mattybigback/RC2014/Boards/README.MD

# RC2014 Boards

These are the resources needed to build the boards I have designed for the RC2014.
