mattybigback/RC2014/BASIC/README.MD

# BASIC
BASIC programs that relate to my boards.
