mattybigback/RC2014/Boards/PPIDE/PPIDE_SCHEMATIC.pdf

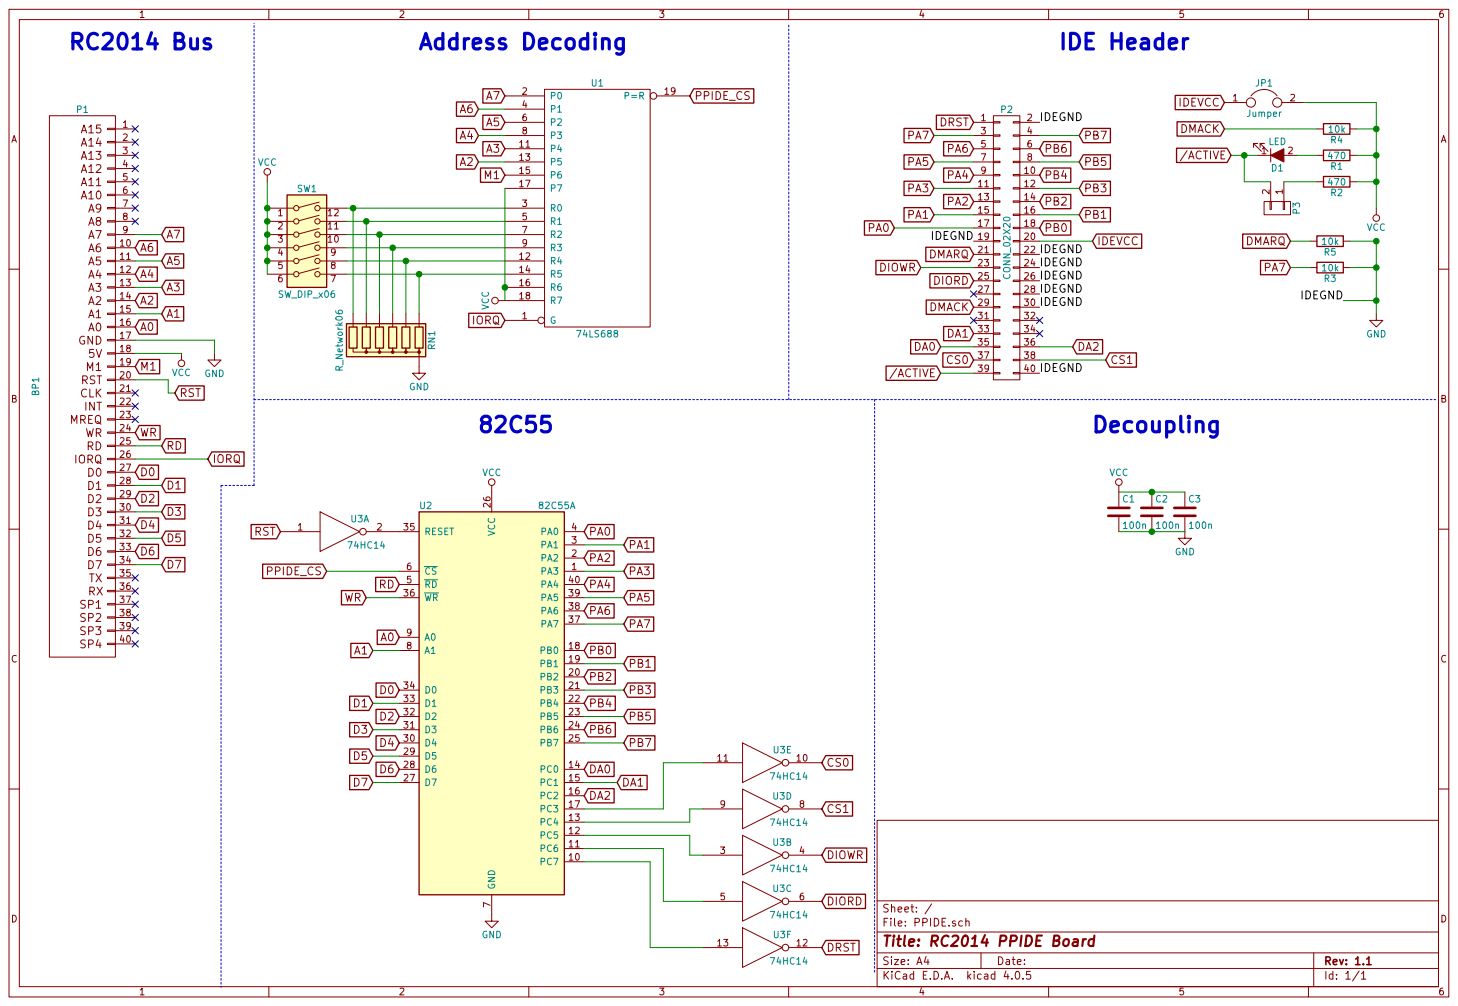
[picture p2: page 1]

File: PPIDE.sch Sheet: /
Id: 1/1 Title: RC2014 PPIDE Board
