mattybigback/RC2014/Boards/ADC Module/Schematic.pdf

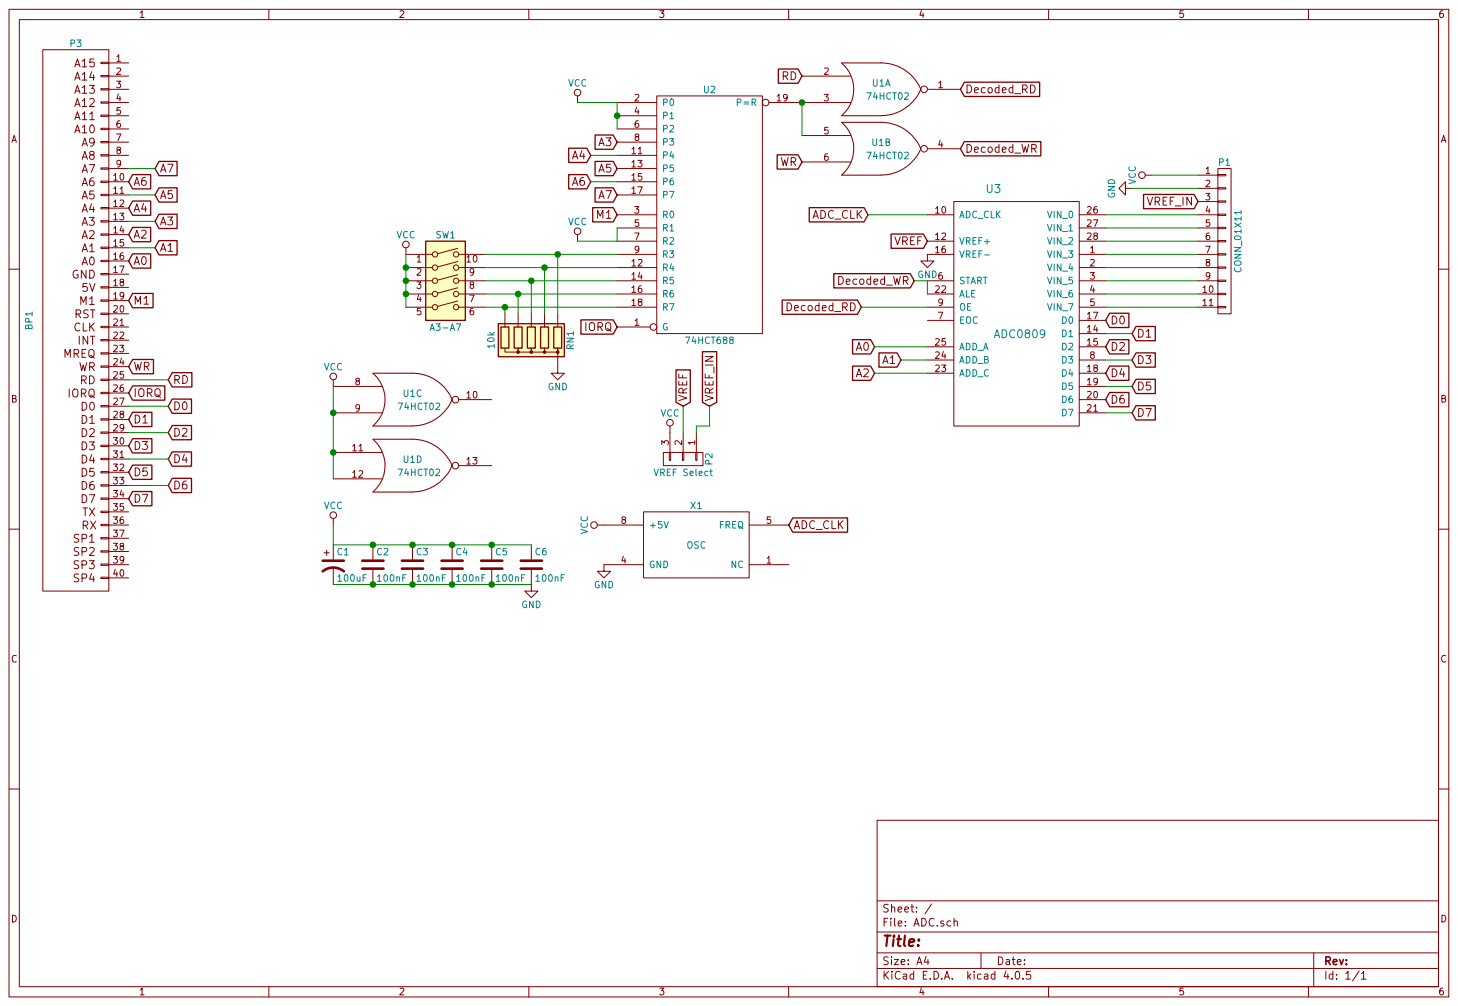
[picture p3: page 1]

Id: 1/1 Title: File: ADC.sch Sheet: /
