mattybigback/RC2014/Boards/PPIDE/KiCAD/PPIDE.kicad_pcb

## KiCad design Boards/PPIDE/KiCAD/PPIDE.kicad_pcb (2017-10-03)

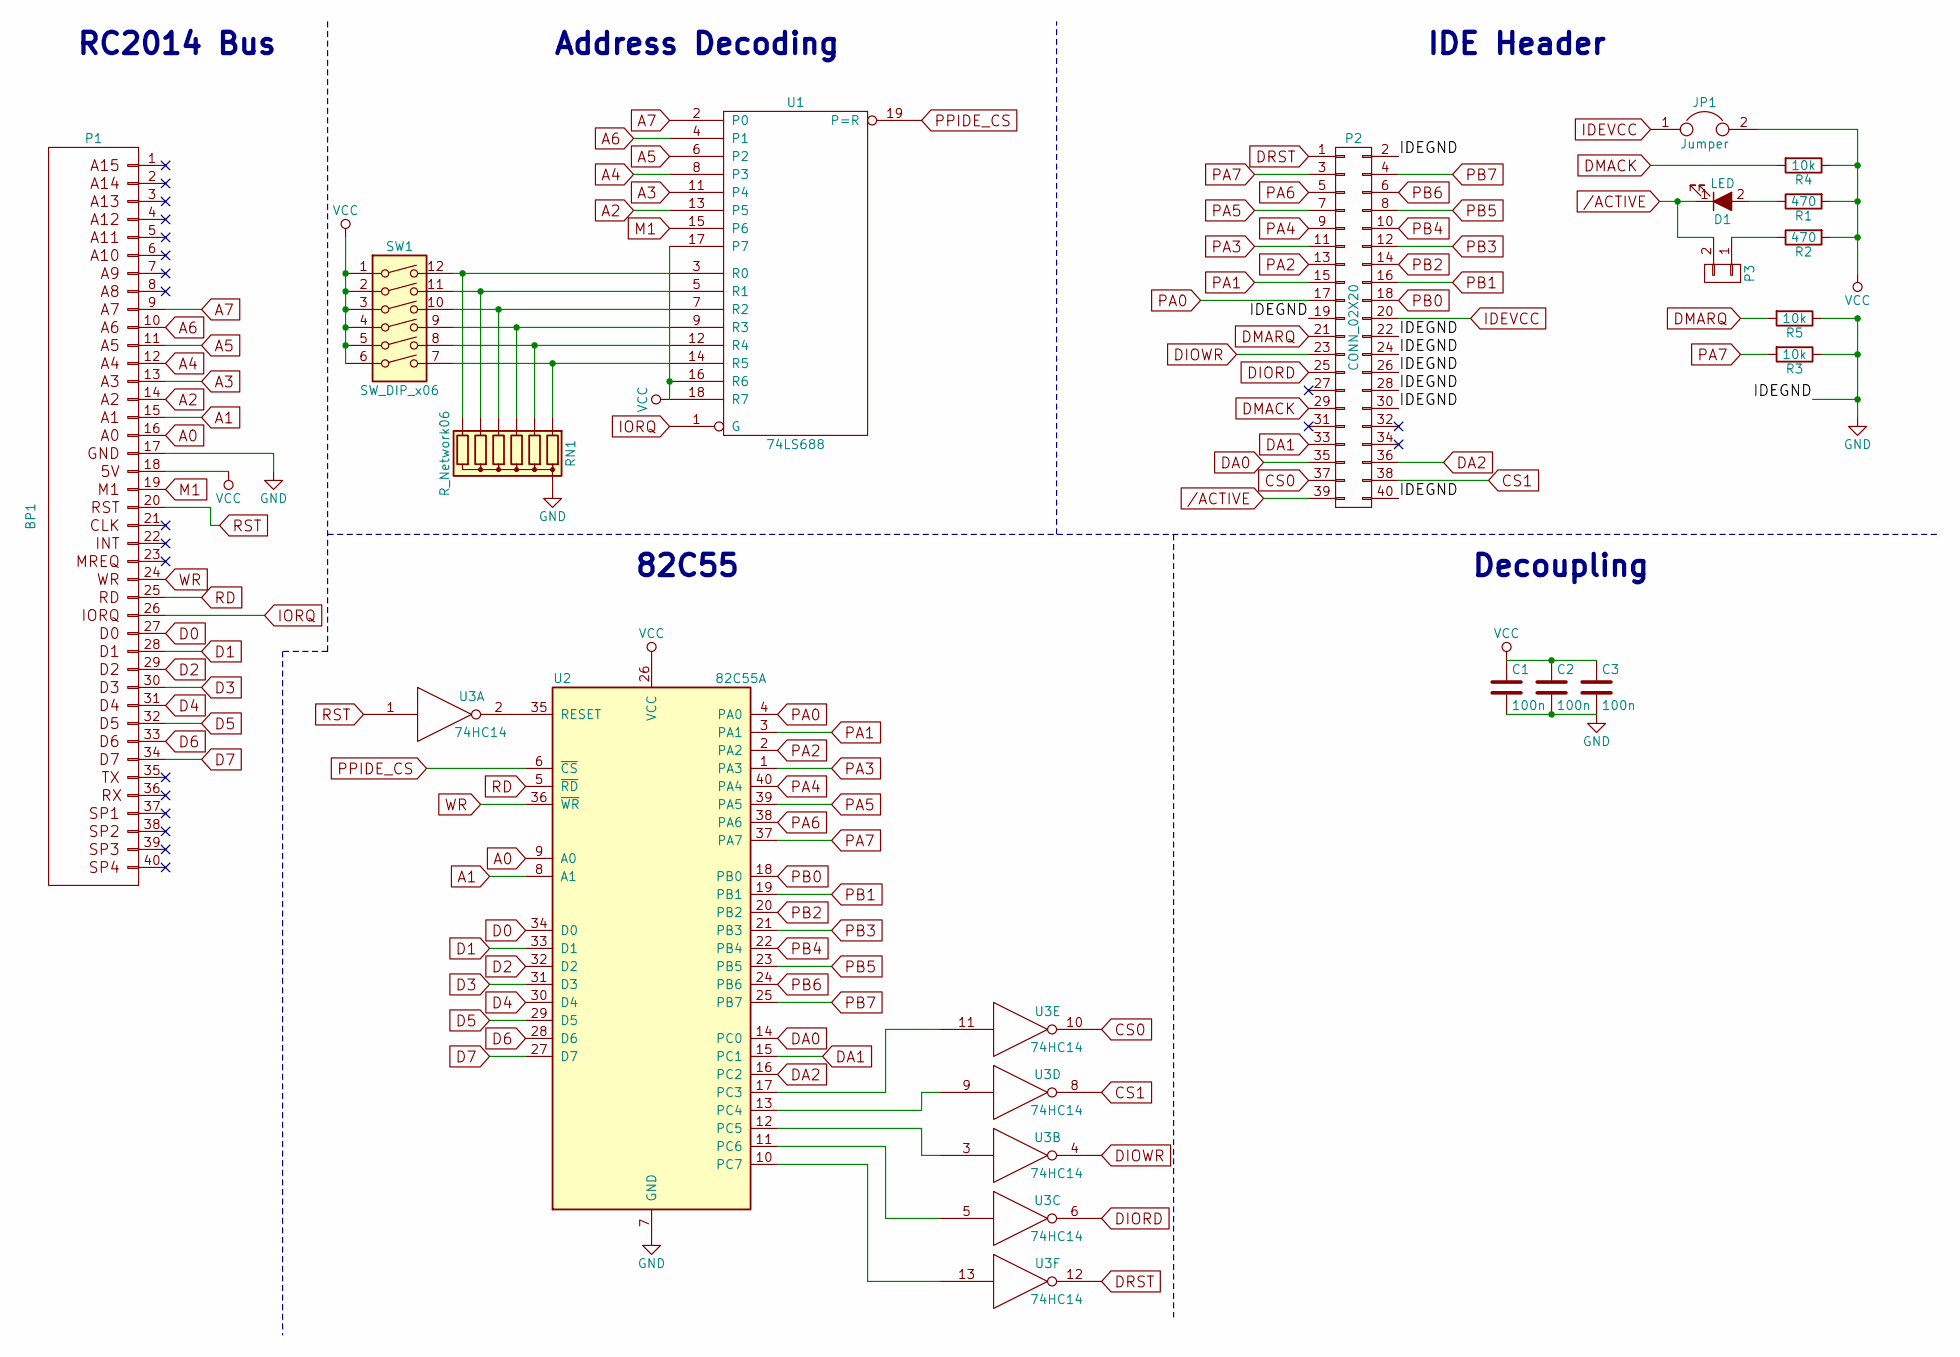
[picture p4: schematic PPIDE.sch, RC2014 PPIDE Board]

Parts:
C1, C2, C3: 100n; C_Disc_D10.0mm_W2.5mm_P5.00mm
D1: LED; LED_D5.0mm_FlatTop
JP1: Jumper; Pin_Header_Straight_1x02_Pitch2.54mm
P1: BP1; Pin_Header_Straight_1x39_Pitch2.54mm
P2: CONN_02X20; IDC_Header_Straight_40pins
P3: CONN_01X02; Pin_Header_Straight_1x02_Pitch2.54mm
R1, R2: 470; R_Axial_DIN0207_L6.3mm_D2.5mm_P10.16mm_Horizontal
R3, R4, R5: 10k; R_Axial_DIN0207_L6.3mm_D2.5mm_P10.16mm_Horizontal
RN1: R_Network06; R_Array_SIP7
SW1: SW_DIP_x06; SW_DIP_x6_W7.62mm_Slide
U1: 74LS688; DIP-20_W7.62mm_Socket_LongPads
U2: 82C55A; DIP-40_W15.24mm
U3: 74HC14; DIP-14_W7.62mm_Socket_LongPads

Connections:
/ACTIVE: D1.1 (K), P2.39, P3.2
A0: P1.16, U2.9 (A0)
A1: P1.15, U2.8 (A1)
A2: P1.14, U1.13 (P5)
A3: P1.13, U1.11 (P4)
A4: P1.12, U1.8 (P3)
A5: P1.11, U1.6 (P2)
A6: P1.10, U1.4 (P1)
A7: P1.9, U1.2 (P0)
CS0: P2.37, U3.10
CS1: P2.38, U3.8
D0: P1.27, U2.34 (D0)
D1: P1.28, U2.33 (D1)
D2: P1.29, U2.32 (D2)
D3: P1.30, U2.31 (D3)
D4: P1.31, U2.30 (D4)
D5: P1.32, U2.29 (D5)
D6: P1.33, U2.28 (D6)
D7: P1.34, U2.27 (D7)
DA0: P2.35, U2.14 (PC0)
DA1: P2.33, U2.15 (PC1)
DA2: P2.36, U2.16 (PC2)
DIORD: P2.25, U3.6
DIOWR: P2.23, U3.4
DMACK: P2.29, R4.2
DMARQ: P2.21, R5.2
DRST: P2.1, U3.12
GND: C1.2, C2.2, C3.2, P1.17, P2.2, P2.19, P2.22, P2.24, P2.26, P2.28, P2.30, P2.40, R3.1, R5.1, RN1.1 (common), U1.10 (GND), U2.7 (GND), U3.7 (GND)
IDEVCC: JP1.1, P2.20
IORQ: P1.26, U1.1 (G)
M1: P1.19, U1.15 (P6)
unnamed: D1.2 (A), R1.1
unnamed: P3.1, R2.1
unnamed: RN1.2 (R1), SW1.7, U1.14 (R5)
unnamed: RN1.3 (R2), SW1.8, U1.12 (R4)
unnamed: RN1.4 (R3), SW1.9, U1.9 (R3)
unnamed: RN1.5 (R4), SW1.10, U1.7 (R2)
unnamed: RN1.6 (R5), SW1.11, U1.5 (R1)
unnamed: RN1.7 (R6), SW1.12, U1.3 (R0)
unnamed: U2.10 (PC7), U3.13
unnamed: U2.11 (PC6), U3.5
unnamed: U2.12 (PC5), U3.3
unnamed: U2.13 (PC4), U3.9
unnamed: U2.17 (PC3), U3.11
unnamed: U2.35 (RESET), U3.2
PA0: P2.17, U2.4 (PA0)
PA1: P2.15, U2.3 (PA1)
PA2: P2.13, U2.2 (PA2)
PA3: P2.11, U2.1 (PA3)
PA4: P2.9, U2.40 (PA4)
PA5: P2.7, U2.39 (PA5)
PA6: P2.5, U2.38 (PA6)
PA7: P2.3, R3.2, U2.37 (PA7)
PB0: P2.18, U2.18 (PB0)
PB1: P2.16, U2.19 (PB1)
PB2: P2.14, U2.20 (PB2)
PB3: P2.12, U2.21 (PB3)
PB4: P2.10, U2.22 (PB4)
PB5: P2.8, U2.23 (PB5)
PB6: P2.6, U2.24 (PB6)
PB7: P2.4, U2.25 (PB7)
PPIDE_CS: U1.19 (P=R), U2.6 (~CS~)
RD: P1.25, U2.5 (~RD~)
RST: P1.20, U3.1
VCC: C1.1, C2.1, C3.1, JP1.2, P1.18, R1.2, R2.2, R4.1, SW1.1, SW1.2, SW1.3, SW1.4, SW1.5, SW1.6, U1.16 (R6), U1.17 (P7), U1.18 (R7), U1.20 (VCC), U2.26 (VCC), U3.14 (VCC)
WR: P1.24, U2.36 (~WR~)

Notes on the sheet:
RC2014 Bus
Address Decoding
82C55
IDE Header
Decoupling

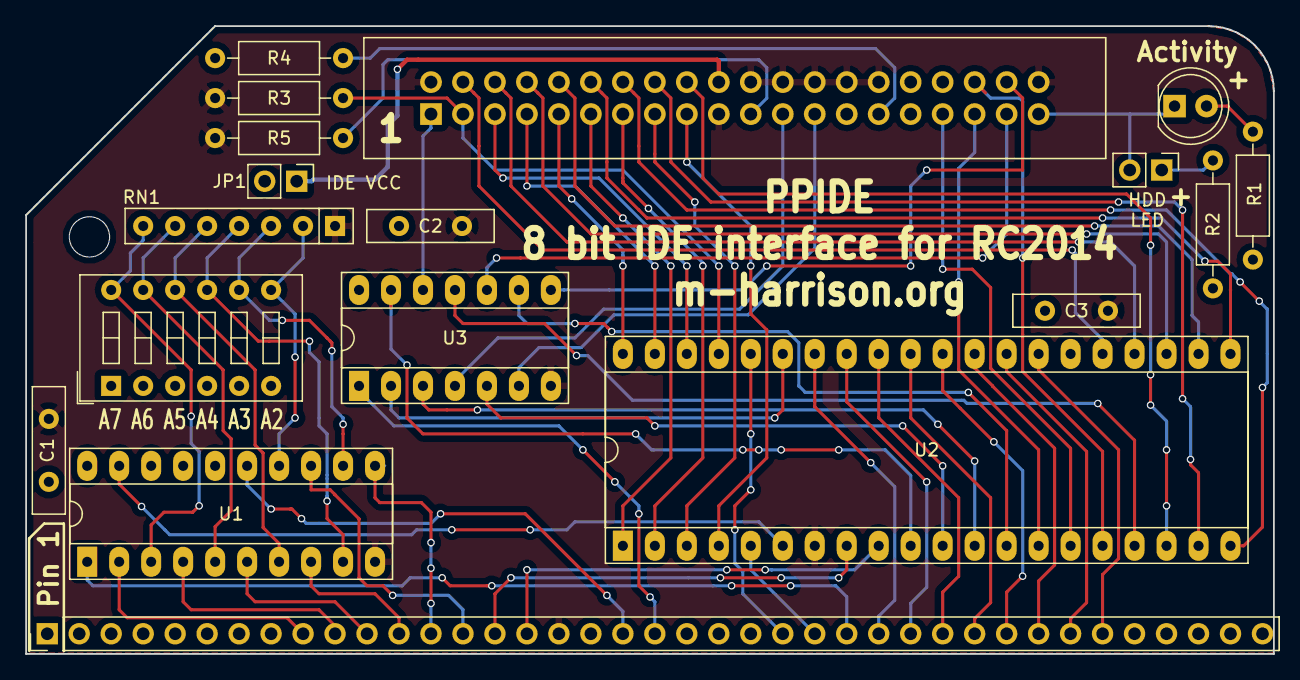
[picture p5: board PPIDE.kicad_pcb from above]

Board: 2 copper layers, 99.1 x 49.9 mm, 18 parts (0 on the bottom side), 66 nets.
